miko53/meteo_station/README.md

# meteo station

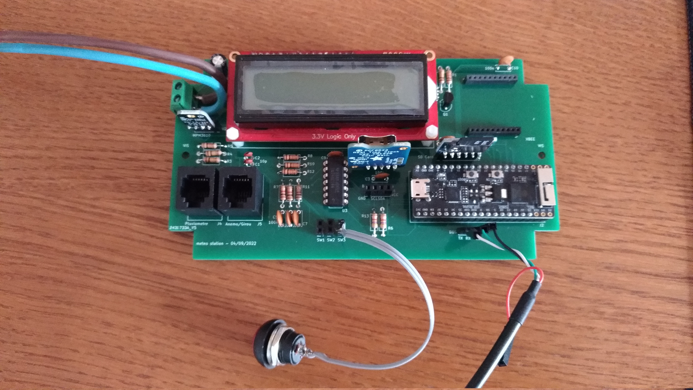
[picture p1: docs/board.jpg]
board
