miko53/meteo_station/hardware/essai_station_meteo.kicad_pcb

## KiCad design hardware/essai_station_meteo.kicad_pcb (2022-09-04)

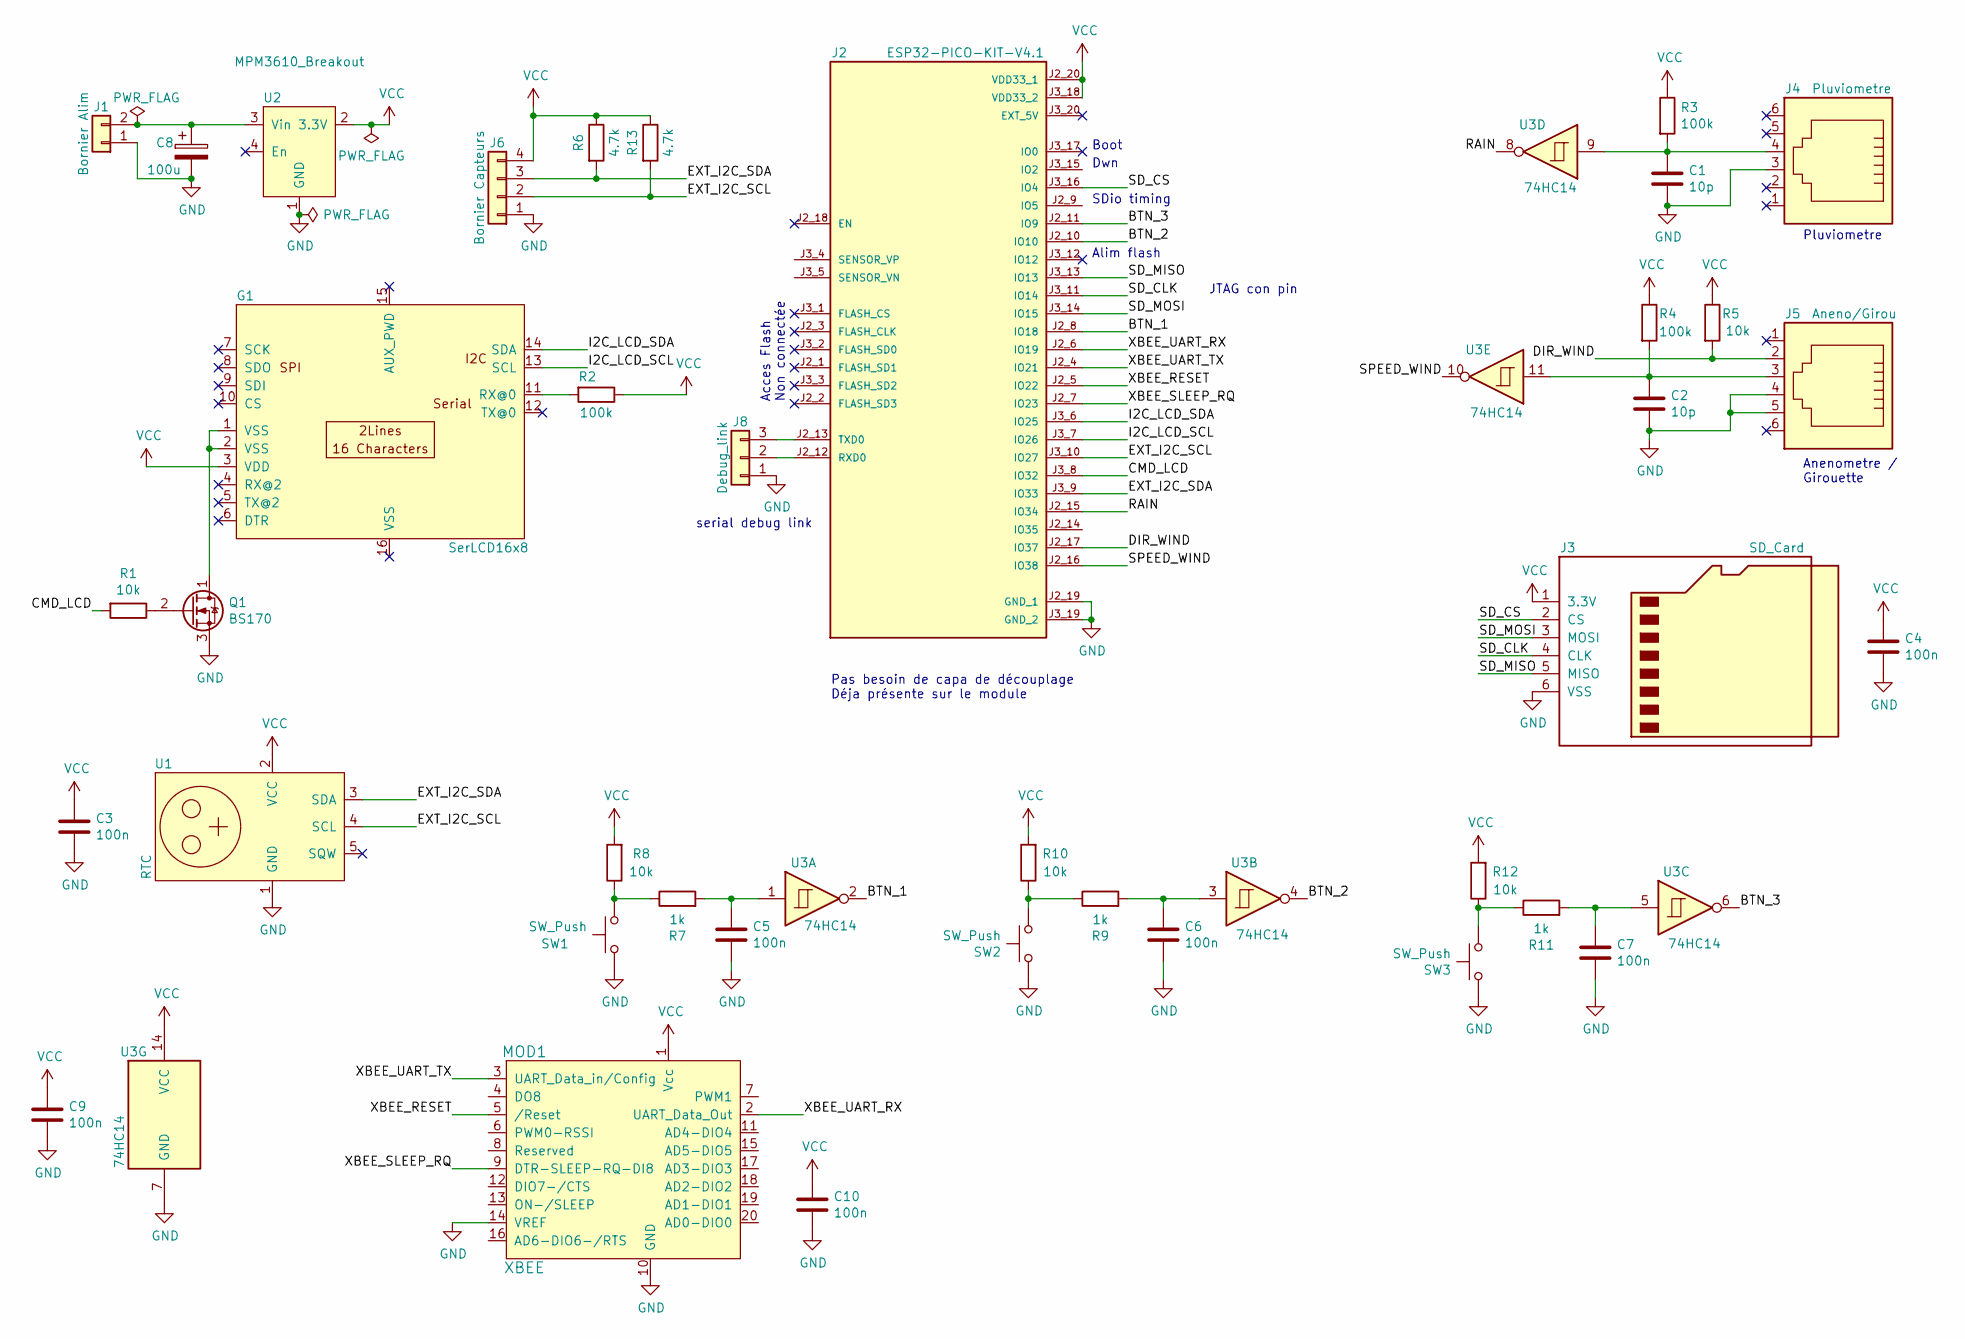
[picture p2: schematic essai_station_meteo.sch]

Parts:
C1, C2: 10p; C_Disc_D3.0mm_W1.6mm_P2.50mm
C3, C4, C5, C6, C7, C9, C10: 100n; C_Disc_D6.0mm_W2.5mm_P5.00mm
C8: 100u; CP_Radial_D8.0mm_P3.50mm
G1: SerLCD16x8; SerLCD16x8Sparkfun
J1: Bornier Alim; Bornier_2pts_L10mm_W7.5mm_P5mm
J2: ESP32-PICO-KIT-V4.1; XCVR_ESP32-PICO-KIT-V4.1; PARTREV 4.1
J3: SD_Card; PinHeader_1x06_P2.54mm_Vertical
J4: Pluviometre; RJ12_Amphenol_54601
J5: Aneno/Girou; RJ12_Amphenol_54601
J6: Bornier Capteurs; PinHeader_1x04_P2.54mm_Vertical
J8: Debug_link; PinHeader_1x03_P2.54mm_Vertical
MOD1: XBEE; XBEE-20_THT; MPN XB24-API-001; Digi-Key_PN 602-1273-ND
Q1: BS170; TO-92_Inline
R1, R5, R8, R10, R12: 10k; R_Axial_DIN0207_L6.3mm_D2.5mm_P10.16mm_Horizontal
R2, R3, R4: 100k; R_Axial_DIN0207_L6.3mm_D2.5mm_P10.16mm_Horizontal
R6, R13: 4.7k; R_Axial_DIN0207_L6.3mm_D2.5mm_P10.16mm_Horizontal
R7, R9, R11: 1k; R_Axial_DIN0207_L6.3mm_D2.5mm_P10.16mm_Horizontal
SW1, SW2, SW3: SW_Push; PinSocket_1x02_P2.54mm_Vertical
U1: RTC; PinHeader_1x05_P2.54mm_Vertical
U2: MPM3610_Breakout; PinSocket_1x04_P2.54mm_Vertical
U3: 74HC14; DIP-14_W7.62mm

Connections:
/BTN_1: J2.J2_8 (IO18), U3.2
/BTN_2: J2.J2_10 (IO10), U3.4
/BTN_3: J2.J2_11 (IO9), U3.6
/CMD_LCD: J2.J3_8 (IO32), R1.2
/DIR_WIND: J2.J2_17 (IO37), J5.2, R5.2
/EXT_I2C_SCL: J2.J3_10 (IO27), J6.2, R13.2, U1.4 (SCL)
/EXT_I2C_SDA: J2.J3_9 (IO33), J6.3, R6.2, U1.3 (SDA)
/I2C_LCD_SCL: G1.13 (SCL), J2.J3_7 (IO26)
/I2C_LCD_SDA: G1.14 (SDA), J2.J3_6 (IO25)
/RAIN: J2.J2_15 (IO34), U3.8
/SD_CLK: J2.J3_11 (IO14), J3.4 (CLK)
/SD_CS: J2.J3_16 (IO4), J3.2 (CS)
/SD_MISO: J2.J3_13 (IO13), J3.5 (MISO)
/SD_MOSI: J2.J3_14 (IO15), J3.3 (MOSI)
/SPEED_WIND: J2.J2_16 (IO38), U3.10
/XBEE_RESET: J2.J2_5 (IO22), MOD1.5 (/Reset); also elsewhere on the board
/XBEE_SLEEP_RQ: J2.J2_7 (IO23), MOD1.9 (DTR-SLEEP-RQ-DI8); also elsewhere on the board
/XBEE_UART_RX: J2.J2_6 (IO19), MOD1.2 (UART_Data_Out); also elsewhere on the board
/XBEE_UART_TX: J2.J2_4 (IO21), MOD1.3 (UART_Data_in/Config); also elsewhere on the board
GND: C1.2, C2.2, C3.2, C4.2, C5.2, C6.2, C7.2, C8.2, C9.2, C10.2, J1.1, J2.J2_19 (GND_1), J2.J3_19 (GND_2), J3.6 (VSS), J4.3, J5.4, J5.5, J6.1, J8.1, MOD1.10 (GND), MOD1.14 (VREF), Q1.3 (S), SW1.1, SW2.1, SW3.1, U1.1 (GND), U2.1 (GND), U3.7 (GND); also elsewhere on the board
unnamed: C1.1, J4.4, R3.2, U3.9
unnamed: C2.1, J5.3, R4.2, U3.11
unnamed: C5.1, R7.2, U3.1
unnamed: C6.1, R9.2, U3.3
unnamed: C7.1, R11.2, U3.5
unnamed: C8.1, J1.2, U2.3 (Vin)
unnamed: G1.1 (VSS), G1.2 (VSS), Q1.1 (D)
unnamed: G1.11 (RX@0), R2.2
unnamed: J2.J2_12 (RXD0), J8.2
unnamed: J2.J2_13 (TXD0), J8.3
unnamed: Q1.2 (G), R1.1
unnamed: R7.1, R8.1, SW1.2
unnamed: R9.1, R10.1, SW2.2
unnamed: R11.1, R12.1, SW3.2
VCC: C3.1, C4.1, C9.1, C10.1, G1.3 (VDD), J2.J2_20 (VDD33_1), J2.J3_18 (VDD33_2), J3.1 (3.3V), J6.4, MOD1.1 (Vcc), R2.1, R3.1, R4.1, R5.1, R6.1, R8.2, R10.2, R12.2, R13.1, U1.2 (VCC), U2.2 (3.3V), U3.14 (VCC); also elsewhere on the board

Notes on the sheet:
Pas besoin de capa de découplage Déja présente sur le module
Pluviometre
Anenometre / Girouette
serial debug link
Boot
Alim flash
Acces Flash Non connectée
Dwn
SDio timing
JTAG con pin

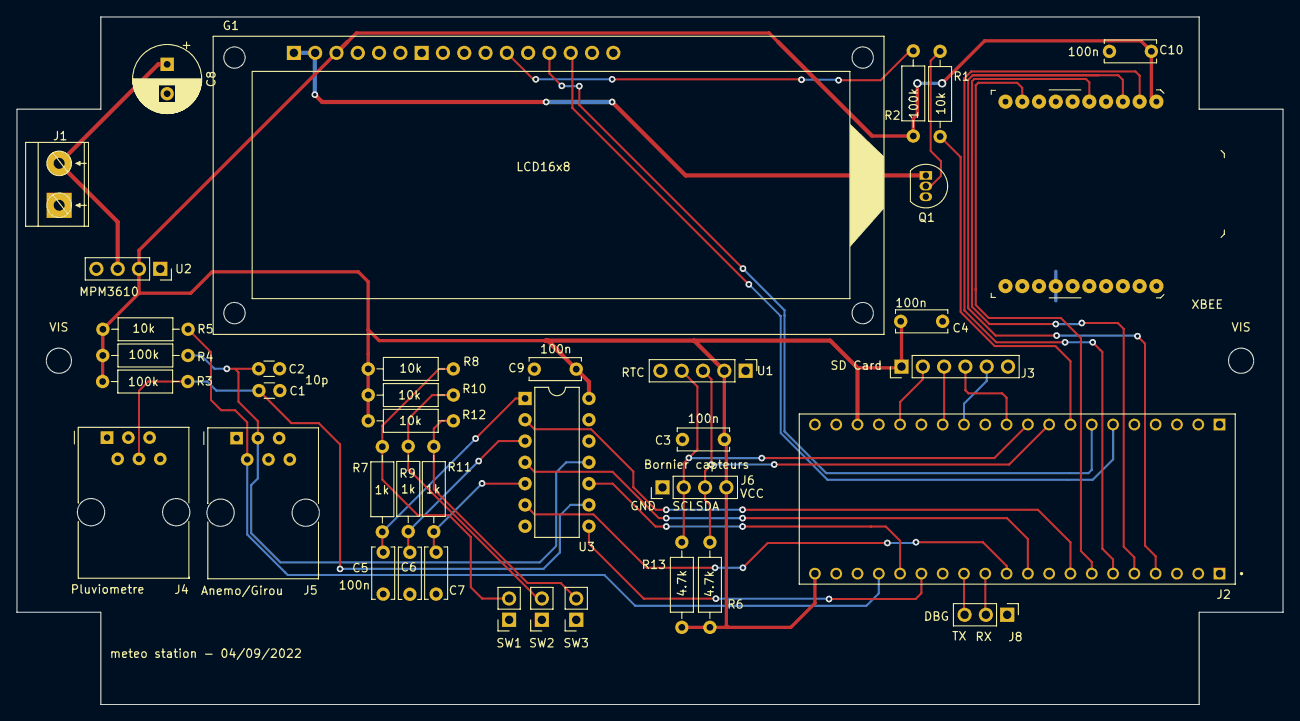
[picture p3: board essai_station_meteo.kicad_pcb from above]

Board: 2 copper layers, 151.0 x 82.0 mm, 41 parts (0 on the bottom side), 35 nets.

Other parts of the board:
VIS: MountingHole_3mm
VIS#2: MountingHole_3mm
XBEE: XBEE; XBEE-20_THT

Their connections:
/XBEE_RESET: XBEE.5; also elsewhere on the board
/XBEE_SLEEP_RQ: XBEE.9; also elsewhere on the board
/XBEE_UART_RX: XBEE.2; also elsewhere on the board
/XBEE_UART_TX: XBEE.3; also elsewhere on the board
GND: XBEE.10, XBEE.14; also elsewhere on the board
VCC: XBEE.1; also elsewhere on the board
