miko53/meteo_station/src/main/winddir.c

#include "winddir.h"
#include "drivers/analog.h"
#include "os.h"
#include "log.h"
#include "data_defs.h"
#include "config.h"

#define WINDDIR_WIDTH         ADC_WIDTH_BIT_12
#define WINDDIR_ATTEN         ADC_ATTEN_DB_11

static void* winddir_analog_handle;
static TimerHandle_t winddir_timer_handle;
static QueueHandle_t ctrl_data_queue;

static void winddir_do_calcul( TimerHandle_t xTimer );

STATUS winddir_init(QueueHandle_t queueData)
{
  STATUS s;

  ctrl_data_queue = queueData;

  s = analog_configure(WINDDIR_GPIO_INPUT, WINDDIR_WIDTH, WINDDIR_ATTEN, &winddir_analog_handle);

  if (s == STATUS_OK)
  {
    winddir_timer_handle = xTimerCreate("winddir_count", OS_SEC_TO_TICK(WINDDIR_WAIT_TIME), pdTRUE, NULL,
                                        winddir_do_calcul);
    if (winddir_timer_handle == NULL)
      s = STATUS_ERROR;
  }

  if (s == STATUS_OK)
  {
    if ( xTimerStart(winddir_timer_handle, 0) != pdPASS )
    {
      log_dbg_print("Timer start error");
      s = STATUS_ERROR;
    }
  }

  return s;
}


char* winddir_direction(winddir_direction_t dir)
{
  char* r;
  switch (dir)
  {
    case N:
      r = "Nord";
      break;
    case NE:
      r = "Nord-Est";
      break;
    case E:
      r = "Est";
      break;
    case SE:
      r = "Sud-Est";
      break;
    case S:
      r = "Sud";
      break;
    case SO:
      r = "Sud-Ouest";
      break;
    case O:
      r = "Ouest";
      break;
    case NO:
      r = "Nord-Ouest";
      break;
    default:
      r = "?";
      break;
  }
  return r;
}

char* winddir_angle_to_direction(float angle)
{
  char* r;
  r = "";
  if ((angle >= 0.) && (angle < 22.5))
  {
    r = "Nord";
  }
  else if ((angle >= 22.5) && (angle < 67.5))
  {
    r = "N-Est";
  }
  else if ((angle >= 67.5) && (angle < 112.5))
  {
    r = "Est";
  }
  else if ((angle >= 112.5) && (angle < 157.5))
  {
    r = "S-Est";
  }
  else if ((angle >= 157.5) && (angle < 202.5))
  {
    r = "Sud";
  }
  else if ((angle >= 202.5) && (angle < 247.5))
  {
    r = "S-Ouest";
  }
  else if ((angle >= 247.5) && (angle < 292.5))
  {
    r = "Ouest";
  }
  else if ((angle >= 292.5) && (angle < 337.5))
  {
    r = "N-Ouest";
  }
  else if (angle >= 337.5)
  {
    r = "Nord";
  }

  return r;
};


uint32_t winddir_get_angle(winddir_direction_t dir)
{
  uint32_t angle;
  switch (dir)
  {
    case N:
      angle = 0;
      break;
    case NE:
      angle = 45;
      break;
    case E:
      angle = 90;
      break;
    case SE:
      angle = 135;
      break;
    case S:
      angle = 180;
      break;
    case SO:
      angle = 225;
      break;
    case O:
      angle = 270;
      break;
    case NO:
      angle = 315;
      break;
    default:
      angle = 360;
      break;
  }
  return angle;
}

void print_direction(winddir_direction_t dir)
{
  log_info_print("Dir: %s", winddir_direction(dir));
}

#ifdef SIMULATED_DATA
uint32_t winddir_simulated;
#endif /* SIMULATED_DATA */

void winddir_do_calcul(TimerHandle_t xTimer)
{
  uint32_t v;
  winddir_direction_t direction;
  v = analog_do_conversion(winddir_analog_handle);
  v = v / 100;
  //log_dbg_print("v %d", v);

  direction = INVALID;
  if (v <= 3)
    direction = E;
  else if ((v > 3) && (v <= 6))
    direction = SE;
  else if ((v > 6) && (v <= 9))
    direction = S;
  else if ((v > 11) && (v <= 15))
    direction = NE;
  else if ((v > 15) && (v <= 20))
    direction = SO;
  else if ((v > 20) && (v <= 25))
    direction = N;
  else if ((v > 25) && (v <= 28))
    direction = NO;
  else if ((v > 28))
    direction = O;

  //print_direction(direction);
  if (ctrl_data_queue != NULL)
  {
    data_msg_t msg;
    msg.sensor = WIND_DIR;
    uint32_t v;

#ifdef SIMULATED_DATA
    UNUSED(direction);
    winddir_simulated += 2;
    winddir_simulated %= 360;
    v = winddir_simulated;
#else
    v = winddir_get_angle(direction);
#endif /* SIMULATED_DATA */

    variant_u32(&msg.value, v);
    xQueueSend(ctrl_data_queue, &msg, OS_WAIT_FOREVER);
  }
}
