miko53/meteo_station/src/main/data_defs.c

#include "data_defs.h"

const char* sensor_name[NB_DATA_TYPE] =
{
  "Precip.",
  "Vit. vent",
  "Dir. vent",
  "Temp.",
  "Humd.",
  "Press",
};

const char* sensor_unit[NB_DATA_TYPE] =
{
  "mm",
  "m/s",
  "",
  "degC",
  "%H",
  "hPa",
};
