miko53/meteo_station/src/main/zb.c

#include <stdint.h>
#include "zb.h"

#define ZB_UNKNOWN_16B_ADDR    (0xFFFE)


uint8_t zb_doChecksum(uint8_t* frame, uint8_t size)
{
  uint8_t checksum;

  checksum = 0xFF;
  for (uint8_t i = 0; i < size; i++)
  {
    checksum -= frame[i];
  }

  return checksum;
}

bool zb_decodage(uint8_t* frame, uint8_t frameSize, zigbee_decodedFrame* decodedFrame)
{
  bool bCorrectlyDecoded;
  uint8_t checksum;
  bCorrectlyDecoded = false;

  if (frameSize >= 1)
  {
    checksum = zb_doChecksum(frame, frameSize - 1);
    if (checksum != frame[frameSize - 1])
    {
      //fprintf(stdout, "Checksum KO\n");
      bCorrectlyDecoded = false;
    }
    else
    {
      bCorrectlyDecoded = true;
    }
  }

  if (bCorrectlyDecoded)
  {
    decodedFrame->type = frame[0];
    switch (frame[0])
    {
      case ZIGBEE_AT_COMMAND_RESPONSE:
        decodedFrame->frameID = frame[1];
        decodedFrame->AT[0] = frame[2];
        decodedFrame->AT[1] = frame[3];
        decodedFrame->status = frame[4];
        decodedFrame->size = frameSize - 6;
        if (decodedFrame->size == 0)
        {
          decodedFrame->data = NULL;
        }
        else
        {
          decodedFrame->data = &frame[5];
        }
        break;

      case ZIGBEE_MODEM_STATUS:
        decodedFrame->status = frame[1];
        bCorrectlyDecoded = true;
        break;

      case ZIGBEE_TRANSMIT_STATUS:
        decodedFrame->frameID = frame[1];
        decodedFrame->status = frame[5];
        break;

      default:
        bCorrectlyDecoded = false;
        break;
    }
  }

  return bCorrectlyDecoded;
}
