miko53/meteo_station/src/main/winddir.h

#ifndef __WINDDIR_H__
#define __WINDDIR_H__

#include "common.h"
#include "os.h"

typedef enum
{
  N,
  NE,
  E,
  SE,
  S,
  SO,
  O,
  NO,
  INVALID
} winddir_direction_t;

#ifdef __cplusplus
extern "C" {
#endif

extern STATUS winddir_init(QueueHandle_t queueData);
extern char* winddir_direction(winddir_direction_t dir);
extern void print_direction(winddir_direction_t dir);
extern uint32_t winddir_get_angle(winddir_direction_t dir);
extern char* winddir_angle_to_direction(float angle);


#ifdef __cplusplus
}
#endif


#endif /* __WINDDIR_H__ */
