miko53/meteo_station/src/main/anemometer.h

#ifndef __ANEMOMETER_H__
#define __ANEMOMETER_H__

#include "common.h"
#include "os.h"

#ifdef __cplusplus
extern "C" {
#endif

extern STATUS anemometer_init(QueueHandle_t queueData);

#ifdef __cplusplus
}
#endif


#endif /* __ANEMOMETER_H__ */
