miko53/meteo_station/src/main/rainmeter.h

#ifndef __RAINMETER_H__
#define __RAINMETER_H__

#include "common.h"
#include "os.h"

#ifdef __cplusplus
extern "C" {
#endif

extern STATUS rainmeter_init(QueueHandle_t queueData);


#ifdef __cplusplus
}
#endif


#endif /* __RAINMETER_H__ */
