miko53/meteo_station/(commit log)

2022-09-04 schematics of meteo station
    [essai_station_meteo.kicad_pcb, essai_station_meteo.sch]
2022-09-04 add name of board + move capa to avoid RTC collision
    [essai_station_meteo.kicad_pcb]
2022-09-24 add I2C init + template of first files
2022-09-25 first driver for ser_lcd screen, freely inspired from arduino one
2022-10-08 add first button events, work in progress
2022-10-09 add button driver
2022-10-09 add first menu, need more work (click to add in button for ex.) to save it
2022-10-15 add rtc driver for pcf8523 with date/time setting
2022-10-23 begin file log creation and fix some error on date, plus some improvement
    [config.h, filelog.c, filelog.h, libs.c, libs.h, main.c, main_test.c]
2022-10-23 fix error when trying to send an empty line to ser_lcd
    [ser_lcd.c]
2022-10-30 fix init status check
    [rainmeter.c]
2022-10-31 centralize thread info, add data_def for manage data reception in ctrl
2022-11-20 add code for fix period and unit test for helper functions to prepare unit test
    [data_ope.c, data_ope.h]
2022-11-20 add test case + bug fix for fix period feature
    [data_ope.c]
2022-11-21 prepare new variant, fix error on default case
    [data_defs.h, data_ope.c]
2022-11-26 renave type in sensor, clean main() function, add data acq in ctrl
2022-11-27 fix update of PM mode on RTC
    [pcf_8523.c]
2022-12-10 add power shutdown of screen, ok now
2023-01-01 add first zb uart interface
2023-01-02 add sending sensor data on zigbee
2023-02-19 fix error on ZB sending data
    [data_defs.h, zigbee.c]
2023-03-05 fix error on display unit
    [data_defs.c, data_defs.h, data_ope.c, data_ope.h]
2023-03-12 fix and add compil option
    [winddir.c]
2023-03-12 fix error on wrong sensor stored
    [ctrl.c, rainmeter.c]
2023-03-12 fix notification ble error, change some log level
    [anemometer.c, ctrl.c, data_ope.c, filelog.c, histogram.c]
2023-03-18 minor log fix, modify frequency to decrease consumption
    [ctrl.c, filelog.c]
2023-05-18 change button order
